nmk456/gamma-spectrometer/readme.md

# Python Environment Setup

Tested on Python 3.13, should work on >=3.9

Windows:

```bat
python3 -m venv venv
venv\Scripts\activate.bat
pip install -r requirements.txt
```

Run sim:

```bat
cd sim

python sim_linear.py
```
