nmk456/gamma-spectrometer/mcad/1593N.stp

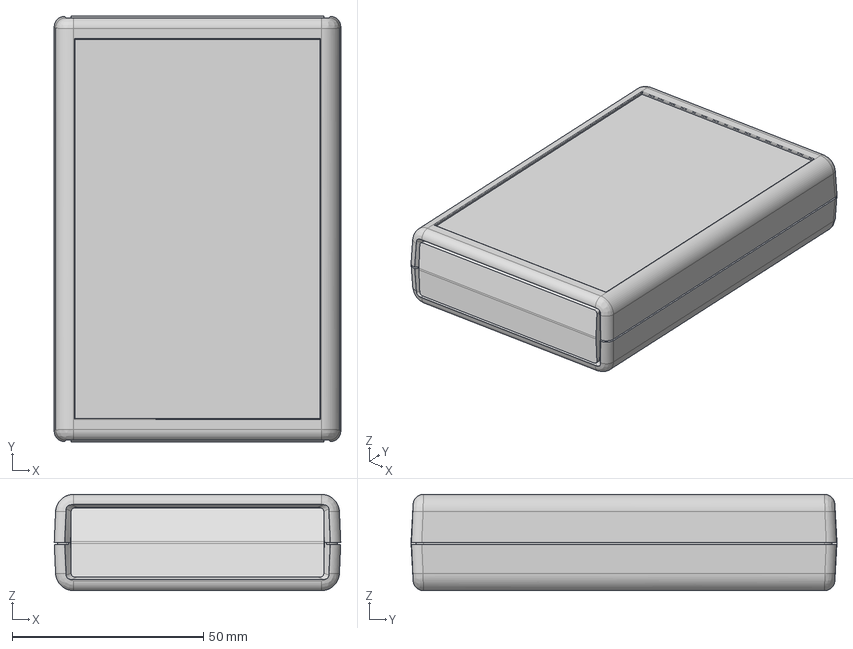
[picture p1: CAD file, 2025-02-15]
mcad/1593N.stp
75.0 x 111.5 x 25.2 mm
1593N Bottom
1593N Top
1593N Flat endpanel x 2
1593N contour endpanel x 2
1593N PCB
