nmk456/gamma-spectrometer/sim/power_supply_linear.asc

&full: fraprobe
&power: fraprobe
@1: fra; delay=6m fstart=500 fend=30k oct=4 nmax=1 pp0=0.1 pp1=0.1 f0=1 f1=1k tavgmin=1m tsettle=0.5m
C1: cap; 220n; Rser=0.3 IC=0
C2: cap; 15p
C4: cap; 68n; IC={V_OUT}
C5: cap; 68n; IC={V_OUT}
C6: cap; 10n; IC={V_OUT}
C7: cap; 10n; IC={V_OUT}
C8: cap; 47µ
C9: cap; 10n
C10: cap; 10n
C11: cap; 10n
C12: cap; 188µ
C13: cap; 33n
D1: zener; BZX84B7V5LY
D2: zener; BZX84B7V5LY
D3: diode; 1N5817
L1: ind; 100µ; Rser=0.205
L2: ind; 100µ; Rser=0.205
Lfb: ind2; {Np**2*Kn/2}; Rser=0.1
Lp1: ind2; {(Np/2)**2 * Kn}; Rser=0.065
Lp2: ind2; {(Np/2)**2 * Kn}; Rser=0.065
Ls: ind2; {Ns**2 * Kn}; Rser=176
M1: nmos; DMG3402L
M2: nmos; DMG3402L
Q1: npn; 2N2222
Q2: npn; 2N2222
R1: res; 1k
R2: res; 10k
R3: res; 1980k
R4: res; 100
R5: res; 330k
R6: res; 46.08k
R7: res; 1
R8: res; 330k
R9: res; 1.2
R10: res; 330k
R11: res; 330k
R12: res; 160k
R13: res; 9Meg
R14: res; 100
R15: res; 3.3k
U1: UniversalOpAmp5; Avol=56k GBW=730k Phimargin=61 SlewPos=250k SlewNeg=250k; En=0 Enk=0 In=0 Ink=0 Rcm=10T Ccm=6p Rdiff=10T Cdiff=6p Ro=1k
U2: sm2000
U3: UniversalOpAmp5; Avol=56k GBW=730k Phimargin=61 SlewPos=250k SlewNeg=250k; En=0 Enk=0 In=0 Ink=0 Rcm=10T Ccm=6p Rdiff=10T Cdiff=6p Ro=1k
U4: sm2000
U5: sm2000
U6: sm2000
V1: voltage; 5
V2: voltage; 4.096
V3: voltage; PULSE(0 5 1m 1u 1u 100 0 1)
Named nets: 0, 5V, FILT, OUT, FB_VGND, em, FB, 5V_FILT, gate, INJECT, FILT_AC, OUT_AC
.param Lp=22u Np=1 Ns=100 Nfb=0.25
.param Kn=Lp/Np**2
K Lp1 Lp2 Ls Lfb 0.99
.tran 20m startup
.fra startup
PMT
.lib S1Y.lib
.lib opa314.lib
.lib DMG3402L.lib
.param V_OUT=-800
R76UN26805050J film caps
22uH across both primaries
pri:sec:fb = 1:100:0.25
9M/800V = 11250 Ohm/V
11250 * 4.096 = 46.08k
