nmk456/gamma-spectrometer/sim/output.asc

C1: cap; 10p
I1: current; EXP(13u 1.3m 200n 1n 0 1000n)
R2: res; 2k
U1: ADA4891-1
V1: voltage; 4.5
Named nets: 0, 5V, in, out
.tran 10u
.lib opa314.lib
