nmk456/gamma-spectrometer/sim/u2.asc

@1: fra; delay=500u fstart=100k fend=3Meg oct=4 pp0=1m pp1=1m f0=1 f1=100k tavgmin=100u
C1: cap; 20p
C2: cap; 1n
R1: res; 43
R2: res; 9Meg
R3: res; 13.891k
R4: res; 0
U1: UniversalOpAmp1; ""
V1: voltage; 4.5
V2: voltage; SINE(-775 0 100k 0 0 0 10000)
Named nets: 0, 4V5, FB, FB_VGND
.lib opa314.lib
.tran 1m
.fra
