nmk456/gamma-spectrometer/sim/power_supply_v1.asc

@1: fra; delay=6m fstart=500 fend=3K oct=4 nmax=1 pp0=2 pp1=0.5 f0=1 f1=1k tavgmin=0.5m tsettle=0.5m
C1: cap; 220n; Rser=0.3
C2: cap; 15p
C3: cap; 12n; IC=1.15
C4: cap; 10n; IC={V_OUT}
C5: cap; 10n; IC={V_OUT}
C6: cap; 10n; IC={V_OUT}
C7: cap; 10n; IC={V_OUT}
C8: cap; 47µ
C9: cap; 10n
C10: cap; 10n
C11: cap; 10n
C12: cap; 188µ
C13: cap; 1n
D5: schottky; 1N5817
L1: ind; 100µ
L2: ind; 100µ
Lfb: ind2; 1.375µ; Rser=0.1
Lp1: ind2; 5.5µ; Rser=0.065
Lp2: ind2; 5.5µ; Rser=0.065
Ls: ind2; 220m; Rser=176
Q1: npn; 2N2222
Q2: npn; 2N2222
R1: res; 10k
R2: res; 1k
R3: res; 1980k
R4: res; 68k
R5: res; 13.7k
R6: res; 13.7k
R7: res; 43
R8: res; 13.7k
R9: res; 1.2
R10: res; 330k
R11: res; 330k
R12: res; 160k
R13: res; 9Meg
R14: res; 191
U1: UniversalOpAmp2; Avol=2.5Meg GBW=3Meg Slew=1.5Meg; Ilimit=20m Rail=0 Vos=0
U2: sm2000
U3: ADP1613
U4: sm2000
U5: sm2000
U6: sm2000
V1: voltage; 5
Named nets: 0, 5V, FILT, OUT, FB_VGND, em, FB, 5V_FILT
K Lp1 Lp2 Ls Lfb 0.99
.tran 50m
.fra
PMT
.lib S1Y.lib
.lib opa314.lib
.param V_OUT=-800
