nmk456/gamma-spectrometer/sim/power_filter.asc

I1: load; PULSE(10m 200m 0.2u 1n 1n 0.3u 1.5u)
V1: voltage; 5; Rser=1
Named nets: 0, 5V
.tran 10u
