nmk456/gamma-spectrometer/driver_v1/driver_v1.kicad_pcb

## KiCad design driver_v1/driver_v1.kicad_pcb (2025-03-01)

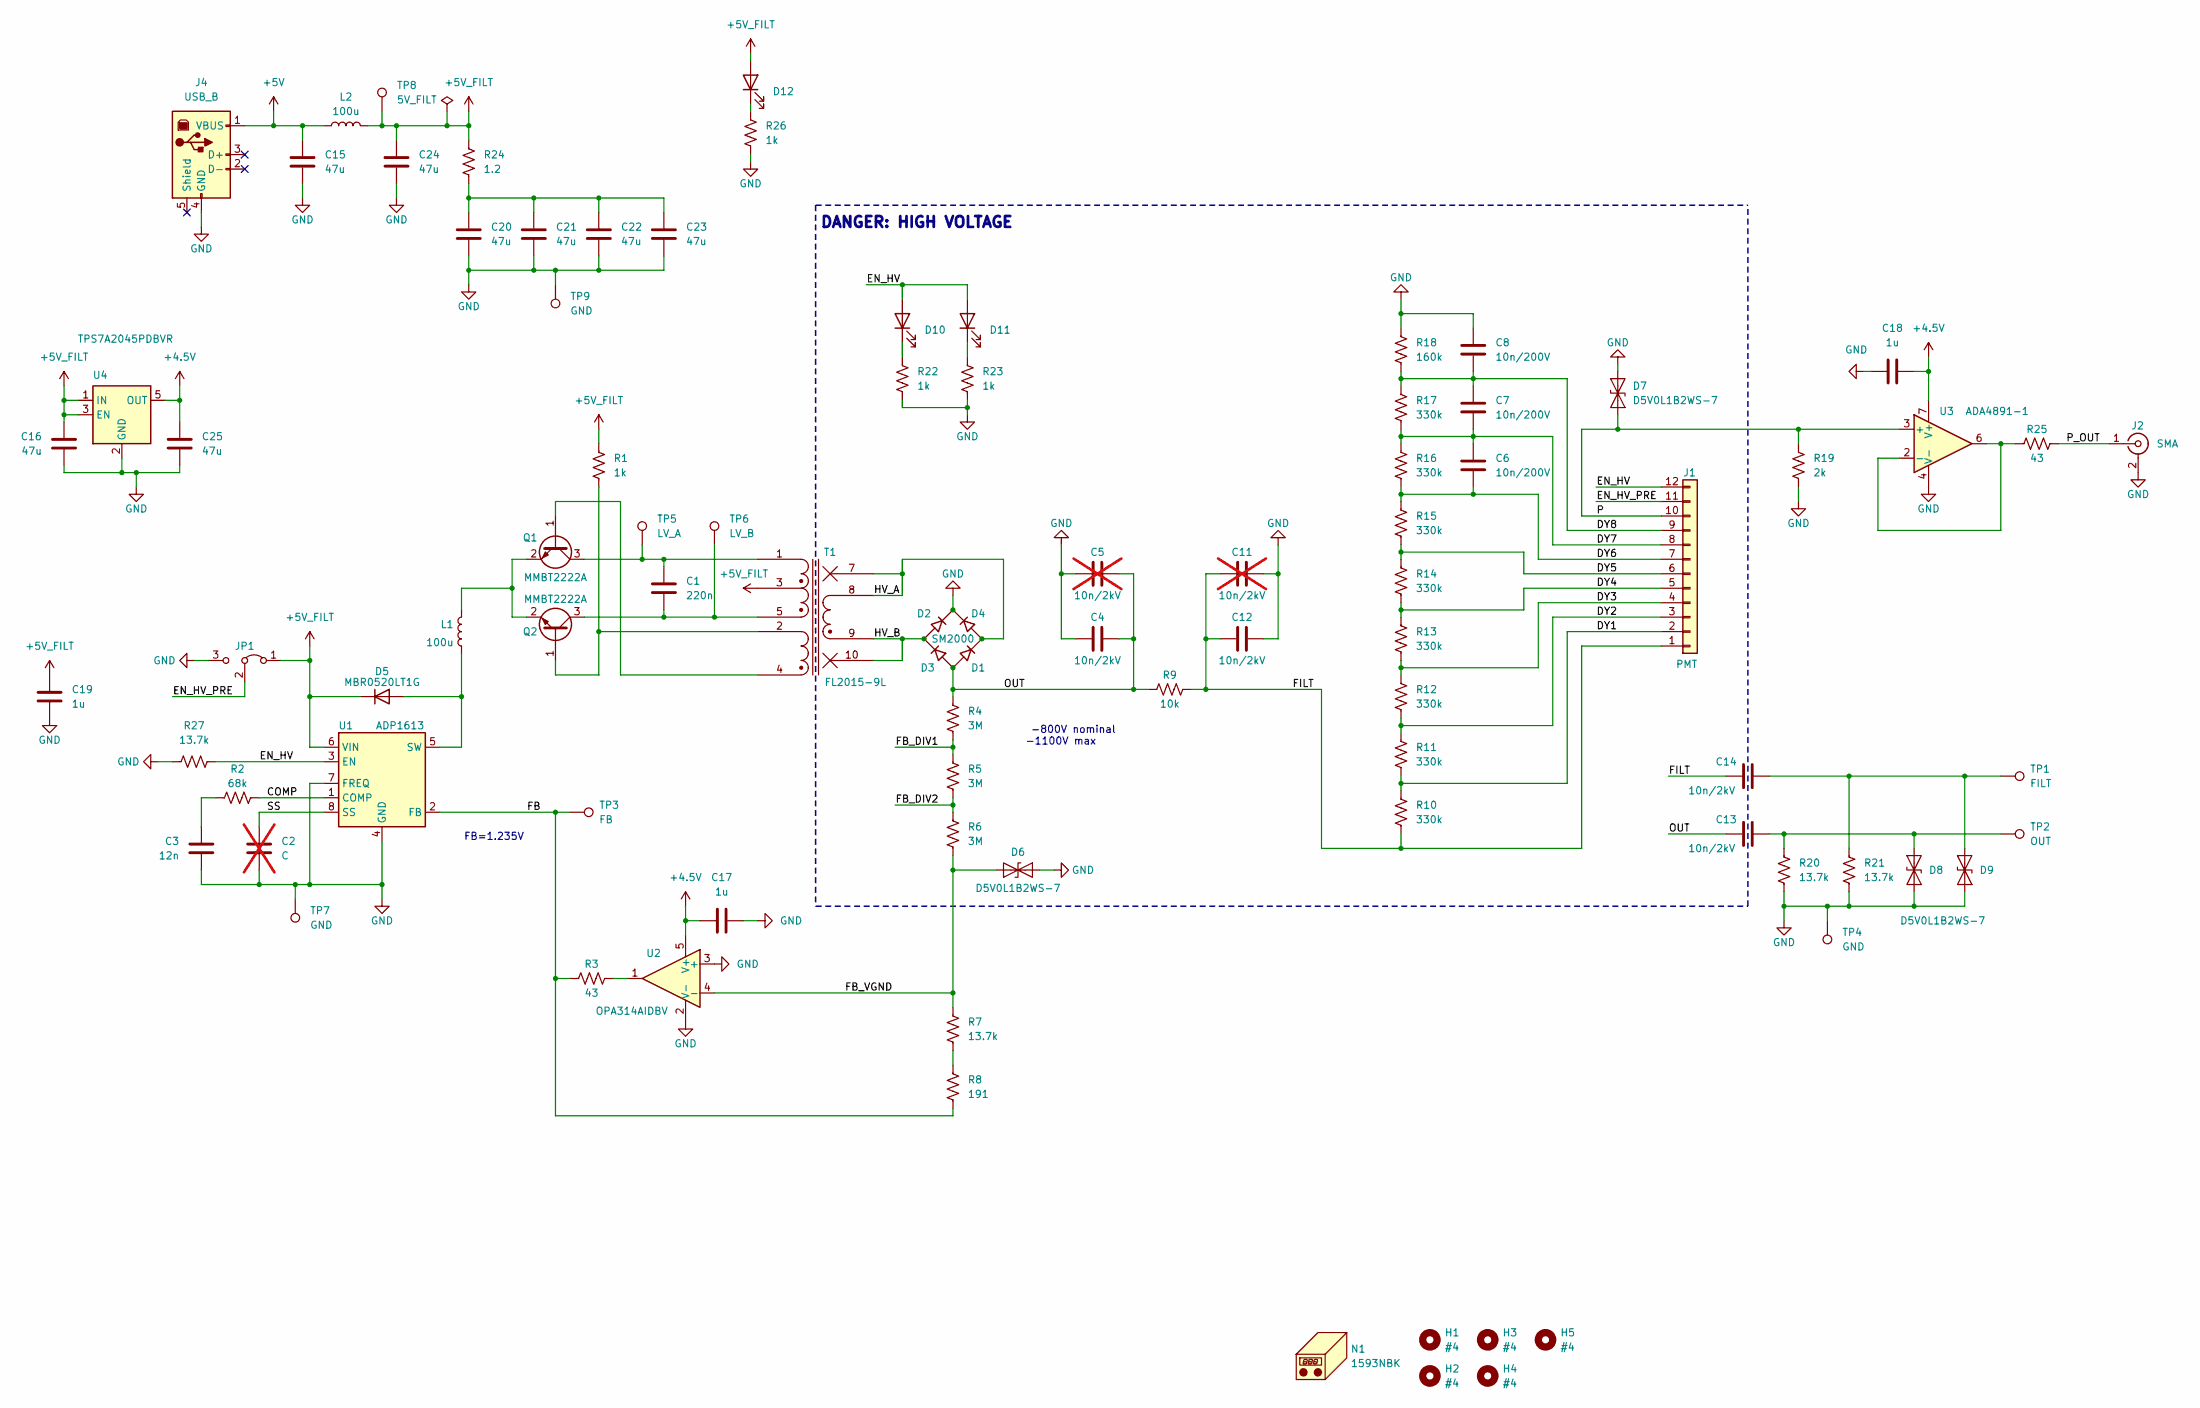
[picture p2: schematic driver_v1.kicad_sch]

Parts:
C1: 220n; C_0805_2012Metric_Pad1.18x1.45mm_HandSolder; DIGIKEY_PN 1276-7012-1-ND
C2: C; C_0603_1608Metric_Pad1.08x0.95mm_HandSolder; not fitted
C3: 12n; C_0603_1608Metric_Pad1.08x0.95mm_HandSolder; DIGIKEY_PN 399-C0603C123K4RACTUCT-ND
C4, C12, C13, C14: 10n/2kV; C_1812_4532Metric_Pad1.57x3.40mm_HandSolder; DIGIKEY_PN 4587-C1812X103K202TCT-ND
C5, C11: 10n/2kV; C_1812_4532Metric_Pad1.57x3.40mm_HandSolder; DIGIKEY_PN 4587-C1812X103K202TCT-ND; not fitted
C6, C7, C8: 10n/200V; C_0805_2012Metric_Pad1.18x1.45mm_HandSolder; DIGIKEY_PN 732-12169-1-ND
C15, C16, C20, C21, C22, C23, C24, C25: 47u; C_1210_3225Metric_Pad1.33x2.70mm_HandSolder; DIGIKEY_PN 587-5922-1-ND
C17, C18, C19: 1u; C_0603_1608Metric_Pad1.08x0.95mm_HandSolder; DIGIKEY_PN 1276-1946-1-ND
D1, D2, D3, D4: SM2000; D_MELF_Handsoldering; DIGIKEY_PN 4878-SM2000CT-ND
D5: MBR0520LT1G; D_SOD-123; DIGIKEY_PN MBR0520LT1GOSCT-ND
D6, D7, D8, D9: D5V0L1B2WS-7; D_SOD-323_HandSoldering; DIGIKEY_PN D5V0L1B2WS-7DICT-ND
D10, D11: LED; LED_D3.0mm_Horizontal_O3.81mm_Z2.0mm; DIGIKEY_PN 67-1058-ND
D12: LED; LED_D3.0mm_Horizontal_O3.81mm_Z2.0mm; DIGIKEY_PN 67-1073-ND
H1, H2, H3, H4, H5: #4; MountingHole_3.2mm_M3; DIGIKEY_PN SR6004-ND
J1: PMT; JST_XH_S12B-XH-A_1x12_P2.50mm_Horizontal; DIGIKEY_PN 455-2221-ND
J2: SMA; SMA_Molex_73251-2200_Horizontal; DIGIKEY_PN WM9352-ND
J4: USB_B; USB_B_OST_USB-B1HSxx_Horizontal; DIGIKEY_PN 102-3999-ND
JP1: Jumper_3_Bridged12; PinHeader_1x03_P2.54mm_Vertical
L1, L2: 100u; L_Taiyo-Yuden_NR-80xx_HandSoldering; DIGIKEY_PN 587-NRS8040T101MJGKCT-ND
N1: 1593NBK; DIGIKEY_PN HM963-ND
Q1, Q2: MMBT2222A; SOT-23_Handsoldering; DIGIKEY_PN MMBT2222A-FDICT-ND
R1, R22, R23, R26: 1k; R_0603_1608Metric_Pad0.98x0.95mm_HandSolder; DIGIKEY_PN P1.00KHCT-ND
R2: 68k; R_0603_1608Metric_Pad0.98x0.95mm_HandSolder; DIGIKEY_PN P68.0KHCT-ND
R3, R25: 43; R_0603_1608Metric_Pad0.98x0.95mm_HandSolder; DIGIKEY_PN P43.0HCT-ND
R4, R5, R6: 3M; R_1206_3216Metric_Pad1.30x1.75mm_HandSolder; DIGIKEY_PN 408-RGV3216P-3004-B-T1CT-ND
R7, R20, R21, R27: 13.7k; R_0603_1608Metric_Pad0.98x0.95mm_HandSolder; DIGIKEY_PN P13.7KDBCT-ND
R8: 191; R_0603_1608Metric_Pad0.98x0.95mm_HandSolder; DIGIKEY_PN P191DBCT-ND
R9: 10k; R_0805_2012Metric_Pad1.20x1.40mm_HandSolder; DIGIKEY_PN P10KACT-ND
R10, R11, R12, R13, R14, R15, R16, R17: 330k; R_0805_2012Metric_Pad1.20x1.40mm_HandSolder; DIGIKEY_PN YAG5980CT-ND
R18: 160k; R_0805_2012Metric_Pad1.20x1.40mm_HandSolder; DIGIKEY_PN 13-RT0805FRE07160KLCT-ND
R19: 2k; R_0603_1608Metric_Pad0.98x0.95mm_HandSolder; DIGIKEY_PN P2.00KHCT-ND
R24: 1.2; R_0603_1608Metric_Pad0.98x0.95mm_HandSolder; DIGIKEY_PN P1.3GCT-ND
T1: FL2015-9L; Coilcraft_FL2015
TP1: FILT; TestPoint_Keystone_5010-5014_Multipurpose; DIGIKEY_PN 36-5013-ND
TP2: OUT; TestPoint_Keystone_5010-5014_Multipurpose; DIGIKEY_PN 36-5013-ND
TP3: FB; TestPoint_Keystone_5010-5014_Multipurpose; DIGIKEY_PN 36-5012-ND
TP4, TP7, TP9: GND; TestPoint_Keystone_5010-5014_Multipurpose; DIGIKEY_PN 36-5011-ND
TP5: LV_A; TestPoint_Keystone_5010-5014_Multipurpose; DIGIKEY_PN 36-5012-ND
TP6: LV_B; TestPoint_Keystone_5010-5014_Multipurpose; DIGIKEY_PN 36-5012-ND
TP8: 5V_FILT; TestPoint_Keystone_5010-5014_Multipurpose; DIGIKEY_PN 36-5010-ND
U1: ADP1613; MSOP-8_3x3mm_P0.65mm; DIGIKEY_PN 505-ADP1613ARMZ-R7CT-ND
U2: OPA314AIDBV; SOT-23-5_HandSoldering; DIGIKEY_PN 296-36699-1-ND
U3: ADA4891-1; SOIC-8_3.9x4.9mm_P1.27mm; DIGIKEY_PN 505-ADA4891-1ARZ-R7CT-ND
U4: TPS7A2045PDBVR; SOT-23-5; DIGIKEY_PN 296-TPS7A2045PDBVRCT-ND

Connections:
+4.5V: C17.1, C18.1, C25.1, U2.5 (V+), U3.7 (V+), U4.5 (OUT)
+5V: C15.1, J4.1 (VBUS), L2.1
+5V_FILT: C16.1, C19.1, C24.1, D5.1 (K), D12.2 (A), JP1.1 (A), L2.2, R1.1, R24.1, T1.3 (IN_B), TP8.1, U1.6 (VIN), U4.1 (IN), U4.3 (EN)
/COMP: R2.2, U1.1 (COMP)
/DY1: J1.2, R10.1, R11.2
/DY2: J1.3, R11.1, R12.2
/DY3: J1.4, R12.1, R13.2
/DY4: J1.5, R13.1, R14.2
/DY5: J1.6, R14.1, R15.2
/DY6: C6.2, J1.7, R15.1, R16.2
/DY7: C6.1, C7.2, J1.8, R16.1, R17.2
/DY8: C7.1, C8.2, J1.9, R17.1, R18.2
/EN_HV: D10.2 (A), D11.2 (A), J1.12, R27.1, U1.3 (EN)
/EN_HV_PRE: J1.11, JP1.2 (C)
/FB: R3.1, R8.1, TP3.1, U1.2 (FB)
/FB_DIV1: R4.2, R5.1
/FB_DIV2: R5.2, R6.1
/FB_VGND: D6.1 (A1), R6.2, R7.2, U2.4 (-)
/FILT: C11.1, C12.1, C14.2, J1.1, R9.2, R10.2
/HV_A: D1.1 (K), D4.2 (A), T1.7 (NC), T1.8 (OUT_A)
/HV_B: D2.2 (A), D3.1 (K), T1.9 (OUT_B), T1.10 (NC)
/OUT: C4.2, C5.2, C13.2, D1.2 (A), D3.2 (A), R4.1, R9.1
/P: D7.1 (A1), J1.10, R19.1, U3.3 (+)
/P_OUT: J2.1 (In), R25.2
/SS: C2.1, U1.8 (SS)
GND: C2.2, C3.2, C4.1, C5.1, C8.1, C11.2, C12.2, C15.2, C16.2, C17.2, C18.2, C19.2, C20.2, C21.2, C22.2, C23.2, C24.2, C25.2, D2.1 (K), D4.1 (K), D6.2 (A2), D7.2 (A2), D8.1 (A1), D9.1 (A1), J2.2 (Ext), J4.4 (GND), JP1.3 (B), R18.1, R19.2, R20.1, R21.1, R22.2, R23.2, R26.2, R27.2, TP4.1, TP7.1, TP9.1, U1.4 (GND), U1.7 (FREQ), U2.2 (V-), U2.3 (+), U3.4 (V-), U4.2 (GND)
unnamed: C3.1, R2.1
unnamed: C20.1, C21.1, C22.1, C23.1, R24.2
unnamed: D5.2 (A), L1.1, U1.5 (SW)
unnamed: C13.1, D8.2 (A2), R20.2, TP2.1
unnamed: C14.1, D9.2 (A2), R21.2, TP1.1
unnamed: D10.1 (K), R22.1
unnamed: D11.1 (K), R23.1
unnamed: D12.1 (K), R26.1
unnamed: Q1.1 (B), T1.4 (FB_B)
unnamed: C1.1, Q1.3 (C), T1.1 (IN_A), TP5.1
unnamed: L1.2, Q1.2 (E), Q2.2 (E)
unnamed: Q2.1 (B), R1.2, T1.2 (FB_A)
unnamed: C1.2, Q2.3 (C), T1.5 (IN_C), TP6.1
unnamed: R3.2, U2.1
unnamed: R7.1, R8.2
unnamed: R25.1, U3.2 (-), U3.6

Notes on the sheet:
FB=1.235V
-800V nominal -1100V max
DANGER: HIGH VOLTAGE

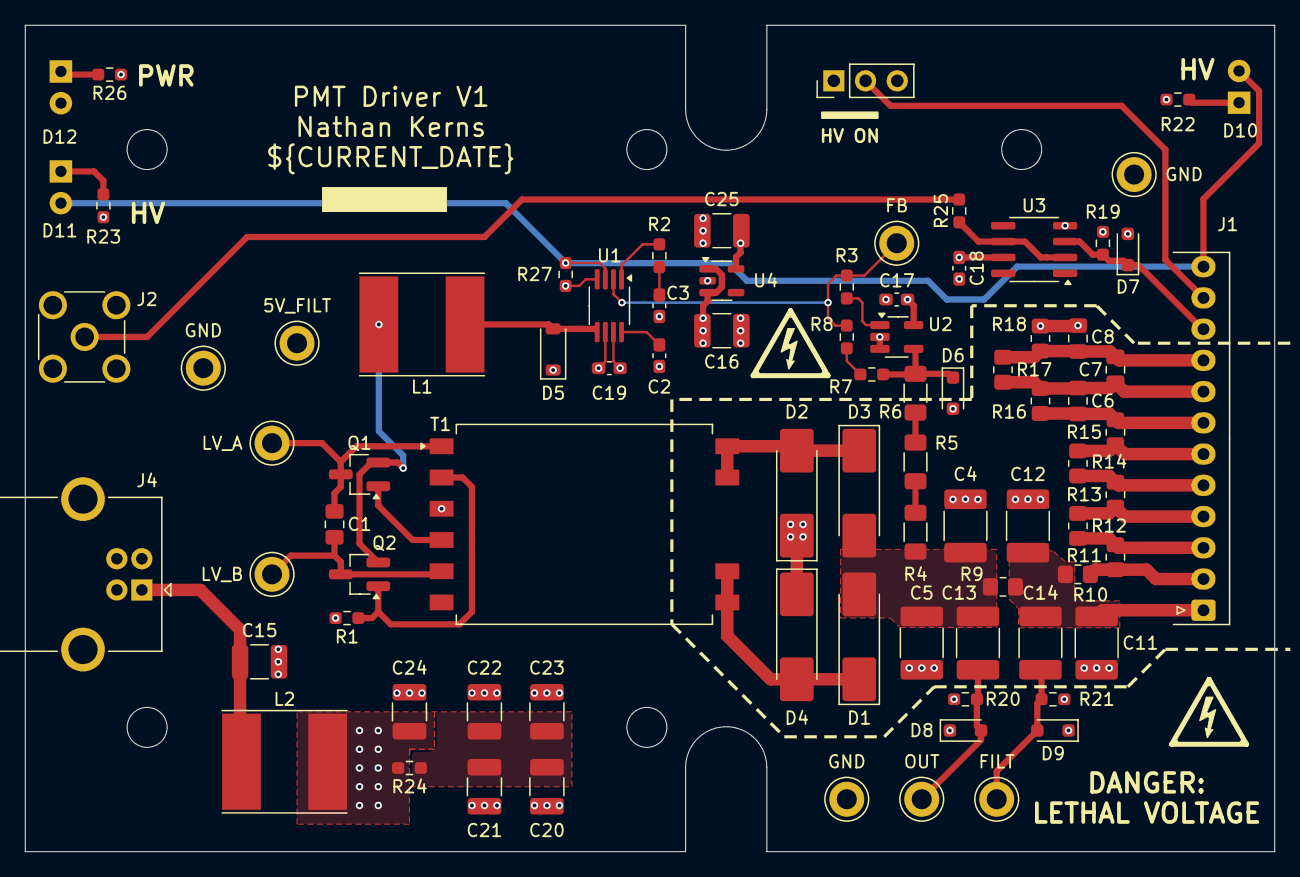
[picture p3: board driver_v1.kicad_pcb from above]

Board: 4 copper layers, 100.0 x 66.1 mm, 89 parts (0 on the bottom side), 42 nets.
