nmk456/gamma-spectrometer/(commit log)

2025-02-15 DC current symbol
    [front_panel.kicad_pcb]
2025-02-15 Swap LEDs, update 3D models
    [driver_v1.kicad_pcb, front_panel.kicad_pcb]
2025-02-15 Increase LED cutout radius, add back panel
    [back_panel.kicad_pcb, back_panel.kicad_sch, back_panel.step]
2025-02-15 Move front panel text
    [back_panel.step, front_panel.kicad_pcb]
2025-02-16 Add script to run all jobsets
    [back_panel.step]
2025-02-16 Include screws in BOM, add serial number location
    [1593N.stp, driver_v1.kicad_pcb, driver_v1.kicad_sch]
2025-03-01 Fix violations for 9.0
    [driver_v1.kicad_pcb, driver_v1.kicad_sch]
2025-03-01 Add fillets to back panel cutout
    [back_panel.kicad_pcb, back_panel.kicad_sch]
2025-06-30 Add BOM, fix datasheet
    [driver_v1.kicad_sch]
2025-08-17 Add enable switch, changed mosfet
